emircan-ipek/modbus-rtu-vfd-parameter-loader/(commit log)

2026-09-21 docs/Parameter Loading Device.docx
2026-09-21 Rename Parameter Loading Device.docx to docs/Parameter Loading Device.docx
2026-09-24 Parameter Loading Device
2026-09-24 Rename Parameter Loading Device.pdf to docs/Parameter Loading Device.pdf
